elilleshi/MIDI-Keyboard/README.md

# MIDI-Keyboard, Spring 2019
Introduction to Digital Logic Circuits: Final Project in VHDL on an FPGA

Spring 2019 Group Project: Eliriana Lleshi, Josh Stone, and Ethan Oliver 

FPGA used: Lattice iCE40UP5K

"midi_final_proj" folder includes the entire folder necessary to burn this project onto an FPGA using Lattice Radiant software. 

Top file: 
- midi_final_proj/top.vhd
- Dependencies: 
  - midi_final_proj/midi_interpreter.vhd
  - midi_final_proj/midi_reciever.vhd
  - midi_final_proj/play_note.vhd
    - midi_final_proj/rom_lut.vhd
  
For more about this project, see "ES4 Final Project Writeup.pdf".
